janavi2008/JPSynth/README.md

# JPSynth
a finger drum machine with 8 drum pads, gesture controls, and its own amp and speaker. its also got a rotary encoder and an oled screen. the pads are piezo discs, and theres a distance sensor, so moving your hand up and down can bend the pitch or distort the sound

# Design
Ive used waveshare esp32 s3 zero module as the microcontroller, 8 piezoelectric discs, a vl53l0x sensor, an EC11 rotary encoder, an 1.3in oled screen, 2 pushbuttons, a MAX98357A amp module, and a 3W 8ohm speaker. i designed the enclosure, lid and caps for the drum pads in CAD.
each pad acts as its own drum - a kick drum, hi-hat, snare, crash, ride, mid tom, high tom and floor tom. one of the buttons will act as a hi-hat pedal. the rotary encoder can control the volume or change the kit. the distance sensor measures how high your left hand is and bends the pitch according to where you move it. the oled screen dispays the settings selected, and shows sound waves while playing.

the firmware is barebones, only the actual drum part and the gesture controls is done. the oled and a couple buttens are left, which ill do during the build as i didnt get enough time.

Schematic:


Pcb:


CAD:


# BOM

| Part | Quantity | Price | Vendor |
| :--- | :---: | :---: | :--- |
| Waveshare ESP32 S3 Zero | 1 | $6.31 | Robu.in |
| VL53L0X sensor | 1 | - | Robu.in |
| MAX98357 module | 1 | - | Robu.in |
| 1.3in OLED display | 1 | - | Robu.in |
| 3W 8Ohm speaker | 1 | - | Robu.in |
| 27mm piezo disc | 8 | $3 | Robu.in |
| smd BAT54S | 8 | $0.2 | Robu.in |
| 0805 smd 1M ohm resistor | 8 | $0.2 | Robu.in |
| 0805 smd 10k ohm resistor | 8 | $0.2 | Robu.in |
| EVA foam 5mm | - | $2 | Amazon.in |
| EC11 rotary encoder | 1 | $0.5 | Robu.in |
| SMD push buttons | 2 | $0.3 | Robu.in |
| 0805 smd 10uf capacitor | 1 | $0.1 | Robu.in |
| 0805 smd 0.1uf capacitor | 3 | $0.1 | Robu.in |
| PCB | 1 | $10 | zbotic.in |
| 3d prints | - | - | - |
