janavi2008/JPSynth/CAD/JPSynth_Assem.SLDASM

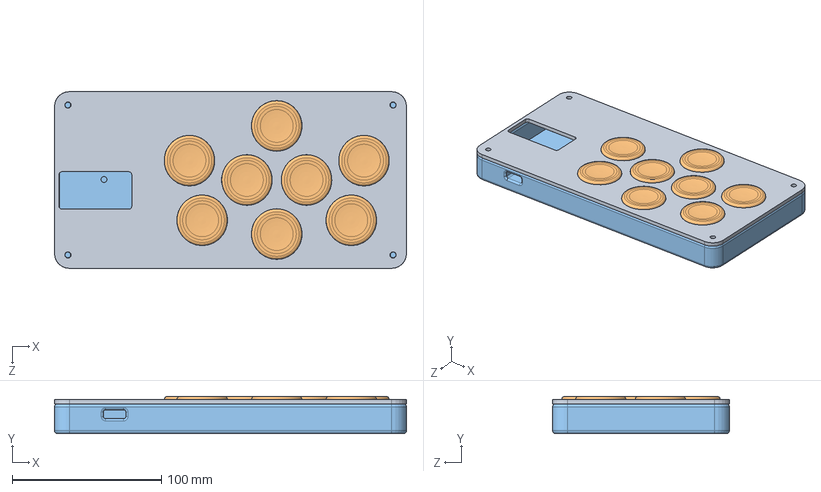
[picture p1: CAD file, 2026-10-25]
CAD/JPSynth_Assem.SLDASM
236.0 x 25.0 x 118.5 mm
CAD
JPSynth_Cap x 8
JPSynth_Lid
