janavi2008/JPSynth/CAD/CAD.SLDPRT

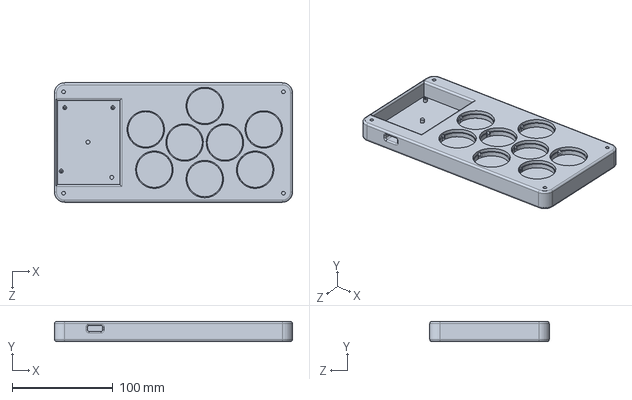
[picture p2: CAD file, 2026-10-25]
CAD/CAD.SLDPRT
236.0 x 20.0 x 118.5 mm
