janavi2008/JPSynth/CAD/JPSynth_Lid.SLDPRT

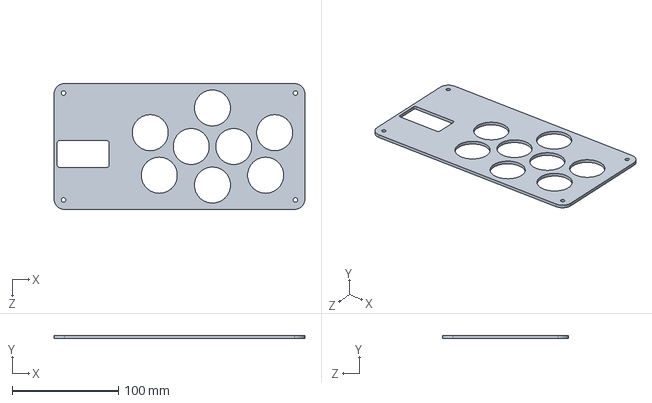
[picture p3: CAD file, 2026-10-25]
CAD/JPSynth_Lid.SLDPRT
236.0 x 3.00 x 118.5 mm
