janavi2008/JPSynth/CAD/JPSynth_Cap.SLDPRT

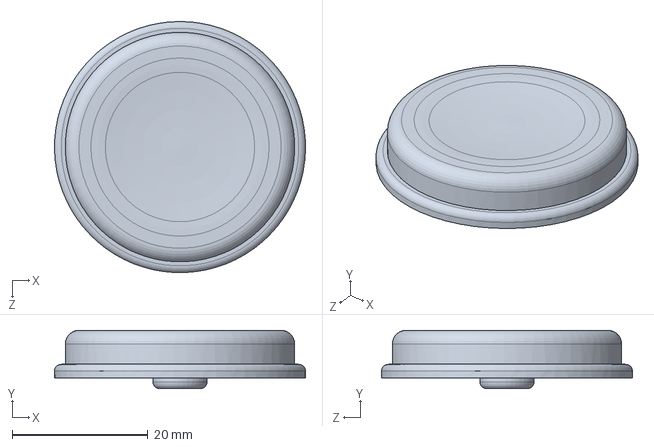
[picture p4: CAD file, 2026-10-25]
CAD/JPSynth_Cap.SLDPRT
37.0 x 8.60 x 37.0 mm
