janavi2008/JPSynth/PCBs/JPSynth.kicad_pcb

## KiCad design PCBs/JPSynth.kicad_pcb (2026-10-25)

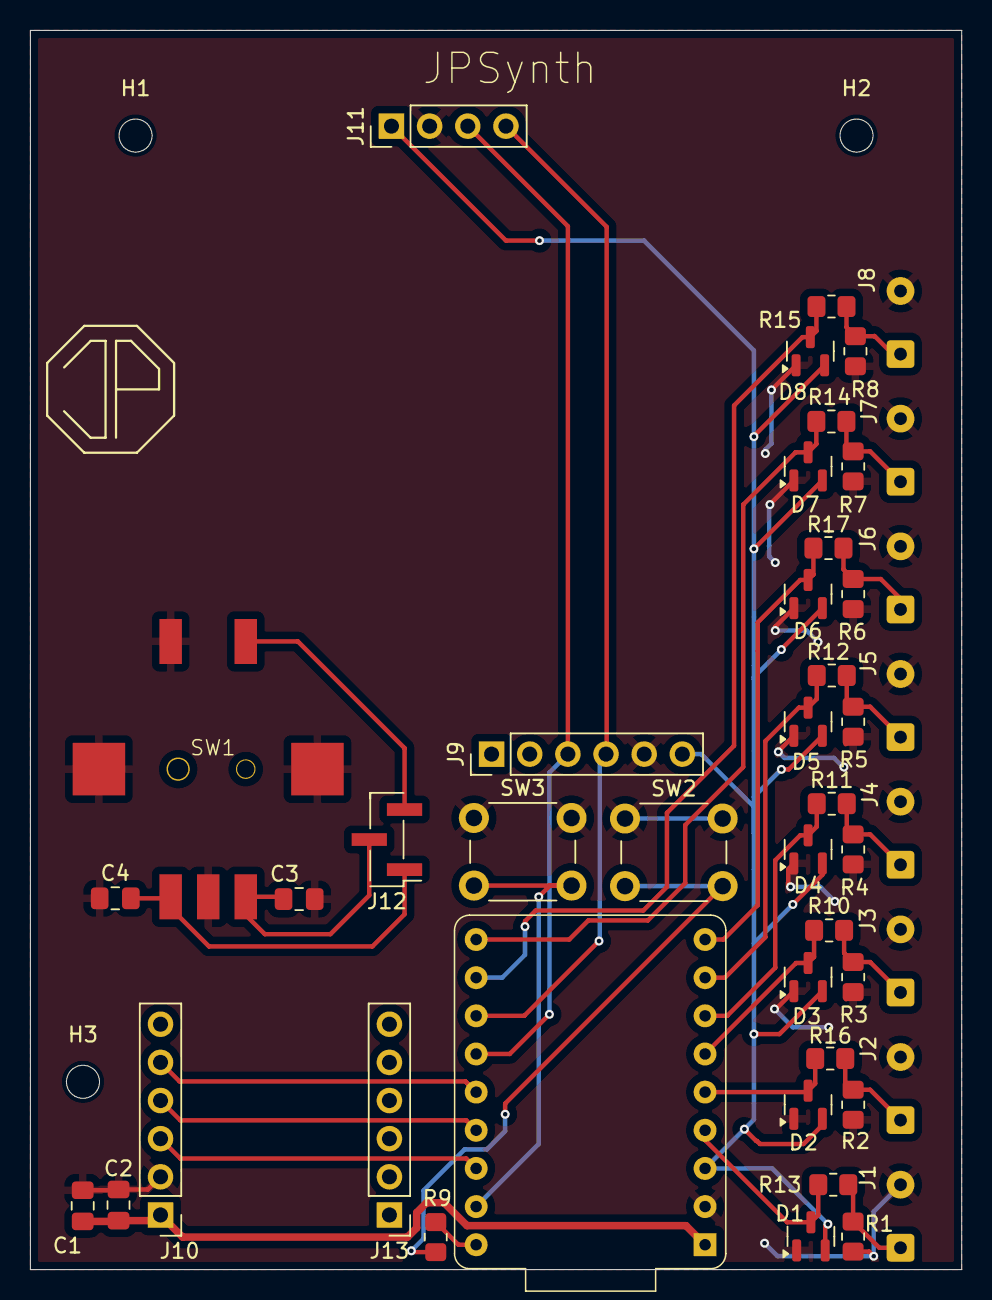
[picture p5: board JPSynth.kicad_pcb from above]

Board: 2 copper layers, 62.0 x 82.5 mm, 49 parts (0 on the bottom side), 30 nets.

Parts:
C1: 10uF; C_0805_2012Metric_Pad1.18x1.45mm_HandSolder
C2: 0.1uF; C_0805_2012Metric_Pad1.18x1.45mm_HandSolder
C3, C4: 0.1uf; C_0805_2012Metric_Pad1.18x1.45mm_HandSolder
D1, D2, D3, D4, D5, D6, D7, D8: BAT54S; SOT-23
H1, H2, H3: MountingHole; MountingHole_2.2mm_M2
J1: Piezo1; SolderWire-0.25sqmm_1x02_P4.2mm_D0.65mm_OD1.7mm
J2: Piezo2; SolderWire-0.25sqmm_1x02_P4.2mm_D0.65mm_OD1.7mm
J3: Piezo3; SolderWire-0.25sqmm_1x02_P4.2mm_D0.65mm_OD1.7mm
J4: Piezo4; SolderWire-0.25sqmm_1x02_P4.2mm_D0.65mm_OD1.7mm
J5: Piezo5; SolderWire-0.25sqmm_1x02_P4.2mm_D0.65mm_OD1.7mm
J6: Piezo6; SolderWire-0.25sqmm_1x02_P4.2mm_D0.65mm_OD1.7mm
J7: PIezo7; SolderWire-0.25sqmm_1x02_P4.2mm_D0.65mm_OD1.7mm
J8: Piezo8; SolderWire-0.25sqmm_1x02_P4.2mm_D0.65mm_OD1.7mm
J9: VL53L0X; PinHeader_1x06_P2.54mm_Vertical
J10: MAX98357A -1; PinHeader_1x06_P2.54mm_Vertical
J11: OLED; PinHeader_1x04_P2.54mm_Vertical
J12: ESP32-extra pads; PinHeader_1x03_P2.00mm_Vertical_SMD_Pin1Left
J13: MAX98357A -2; PinHeader_1x06_P2.54mm_Vertical
R1, R2, R3, R4, R5, R6, R7, R8: 1M; R_0805_2012Metric_Pad1.20x1.40mm_HandSolder
R9: 1k; R_0805_2012Metric_Pad1.20x1.40mm_HandSolder
R10, R11, R12, R13, R14, R15, R16, R17: 10k; R_0805_2012Metric_Pad1.20x1.40mm_HandSolder
SW1: RotaryEncoder_Switch_MP; rotary encoder
SW2, SW3: SW_Push; SW_PUSH_6mm
U1: ESP32-S3-Zero; Waveshare-ESP32-S3-Zero

Connections:
/+3V3: D1.2 (K), D2.2 (K), D3.2 (K), D4.2 (K), D5.2 (K), D6.2 (K), D7.2 (K), D8.2 (K), J9.6, J11.1, U1.3 (3V3(OUT))
/+5V: C1.1, C2.1, J10.1, U1.1 (VDD)
/GND: C1.2, C2.2, C3.2, C4.1, D1.1 (A), D2.1 (A), D3.1 (A), D4.1 (A), D5.1 (A), D6.1 (A), D7.1 (A), D8.1 (A), J1.2, J2.2, J3.2, J4.2, J5.2, J6.2, J7.2, J8.2, J9.5, J10.2, J11.2, R1.2, R2.2, R3.2, R4.2, R5.2, R6.2, R7.2, R8.2, SW1.1, SW1.3, SW1.5, SW2.1, SW3.1, U1.2 (GND)
/GPIO1_D1: D1.3 (COM), R13.2, U1.4 (GPIO1)
/GPIO2_D2: D2.3 (COM), R16.2, U1.5 (GPIO2)
/GPIO3_D3: D3.3 (COM), R10.2, U1.6 (GPIO3)
/GPIO4_D4: D4.3 (COM), R11.2, U1.7 (GPIO4)
/GPIO5_D5: D5.3 (COM), R12.2, U1.8 (GPIO5)
/GPIO6_D6: D6.3 (COM), R17.2, U1.9 (GPIO6)
/GPIO7_D7: D7.3 (COM), R14.2, U1.10 (GPIO7)
/GPIO8_D8: D8.3 (COM), R15.2, U1.11 (GPIO8)
/GPIO9_SDA: J9.4, J11.4, U1.12 (GPIO9)
/GPIO10_SCL: J9.3, J11.3, U1.13 (GPIO10)
/GPIO11_DIN: J10.5, U1.14 (GPIO11)
/GPIO12_BCLK: J10.4, U1.15 (GPIO12)
/GPIO13_LRC: J10.3, U1.16 (GPIO13)
/GPIO14: J12.3, SW1.6
/GPIO15: C3.1, J12.2, SW1.4
/GPIO16: C4.2, J12.1, SW1.2
/SW2_TX: R9.2, U1.18 (TX)
/SW3_RX: SW3.2, U1.17 (RX)
unnamed: J1.1, R1.1, R13.1
unnamed: J2.1, R2.1, R16.1
unnamed: J3.1, R3.1, R10.1
unnamed: J4.1, R4.1, R11.1
unnamed: J5.1, R5.1, R12.1
unnamed: J6.1, R6.1, R17.1
unnamed: J7.1, R7.1, R14.1
unnamed: J8.1, R8.1, R15.1
unnamed: R9.1, SW2.2
