janavi2008/JPSynth/JOURNAL.md

# JPSynth – devlog

<!-- Generated by Half Life from project cmvespvqc0a1q01rc3e3982db. Edits here are overwritten on the next sync. -->
<!-- Generated: 2026-10-24T20:44:40.041Z -->

> [!NOTE]
> This devlog is mirrored from [Half Life](https://halflife.hackclub.com) – [open the project](https://halflife.hackclub.com/projects/cmvespvqc0a1q01rc3e3982db). Editing it here will not change the platform's copy, and the next sync overwrites this file.

> a finger drum pad with gesture controls - it has 8 drum pads, and a distance sensor for gesture controls( moving your hand up or down to sweep a filter or bend the pitch)

| Week | Tier | Hours logged | Entries |
| --- | --- | --- | --- |
| Week 3 | Tier 2 | 12.28h | 5 |

## Contents

1. [2026-10-20 – Started off with the schematic, and just over an hour in it already so messy. i should have spaced it out more, but its alright. today i just finished off the drum pads, the sensors, amp, buttons, spe](#2026-10-20-started-off-with-the-schematic-and-just-over-an-h)
2. [2026-10-21 – finished the schematic, and i made some changes - added an oled and a rotary encoder. i had alot of trouble witht he footprints this time since im mostly using modules, it was a while before i figured](#2026-10-21-finished-the-schematic-and-i-made-some-changes---)
3. [2026-10-22 – Finished the entire pcb today, started by assigning lables in the schematic to make it easier to understand. it was smooth sailing after that, and i got the pcb designed and routed pretty easily. i co](#2026-10-22-finished-the-entire-pcb-today-started-by-assignin)
4. [2026-10-23 – i made some changes to the pcb, added 2 push buttons because i realised i can also use rx and tx as i/o pins(with some limitations). i also added mounting holes to the pcb, and added design clearances](#2026-10-23-i-made-some-changes-to-the-pcb-added-2-push-butto)
5. [2026-10-24 – I finished up the cad, added a lid that I'm gonna get cut into acrylic so it's see through, and designed the caps for the drum pads. Ive decided the materials for the inner part of the pads(eva). One](#2026-10-24-i-finished-up-the-cad-added-a-lid-that-im-gonna-g)

## Design

### 2026-10-20 – Started off with the schematic, and just over an hour in it already so messy. i should have spaced it out more, but its alright. today i just finished off the drum pads, the sensors, amp, buttons, spe

**1.32h**

Started off with the schematic, and just over an hour in it already so messy. i should have spaced it out more, but its alright. today i just finished off the drum pads, the sensors, amp, buttons, speakers ill do next session.
heres the schematic till now



[Timelapse](https://lookout.hackclub.com/api/media/a15c3f82-49b0-4342-b299-bd029b77fd37/video.mp4)

### 2026-10-21 – finished the schematic, and i made some changes - added an oled and a rotary encoder. i had alot of trouble witht he footprints this time since im mostly using modules, it was a while before i figured

**2.58h**

finished the schematic, and i made some changes - added an oled and a rotary encoder. i had alot of trouble witht he footprints this time since im mostly using modules, it was a while before i figured i just had to add header pins. i did have to create a custom footprint for the rotary encoder, but thankfully there was adatasheet with all the dimensions.
heres the final(ish) schematic



[Timelapse](https://lookout.hackclub.com/api/media/00f93358-e980-4481-893a-c57018e11910/video.mp4)

### 2026-10-22 – Finished the entire pcb today, started by assigning lables in the schematic to make it easier to understand. it was smooth sailing after that, and i got the pcb designed and routed pretty easily. i co

**3.58h**

Finished the entire pcb today, started by assigning lables in the schematic to make it easier to understand. it was smooth sailing after that, and i got the pcb designed and routed pretty easily. i considered removing one drum pad in favour of a button or slider(ive currently maxed out my i/o pins), but decided against it for now cuz i dont even know what id use the button for, as my rotary encoder plus gesture sensor already covers everything. i thought id start off with the cad, but solidworks had different ideas- it hung literally 1 minute after i opened it, so i decided to call it a day

heres the updated schematic and pcb:





[Timelapse](https://lookout.hackclub.com/api/media/58ecd70d-abc6-41af-927c-59f197b77dbb/video.mp4)

### 2026-10-23 – i made some changes to the pcb, added 2 push buttons because i realised i can also use rx and tx as i/o pins(with some limitations). i also added mounting holes to the pcb, and added design clearances

**2.98h**

i made some changes to the pcb, added 2 push buttons because i realised i can also use rx and tx as i/o pins(with some limitations). i also added mounting holes to the pcb, and added design clearances cuz i had forgotten to earlier. i designed the base of the enclosure, and i and im happy with how it turned out, though right now my usb cord will have to go through a 15mm tunnel to reach the esp32 port, so i might have to change that.i did some research to figure out what material and how thick the pads have to be(piezo sensor sandwiched between foam/rubber), though im still not entirely sure on how to design them for max sensitivity.

heres the enclosure:


[Timelapse](https://lookout.hackclub.com/api/media/802de4b8-7ace-4907-97e4-b3e4006c3694/video.mp4)

[Timelapse](https://lookout.hackclub.com/api/media/d4d22928-646a-42d3-9ae7-a29f25475254/video.mp4)

### 2026-10-24 – I finished up the cad, added a lid that I'm gonna get cut into acrylic so it's see through, and designed the caps for the drum pads. Ive decided the materials for the inner part of the pads(eva). One

**1.82h**

I finished up the cad, added a lid that I'm gonna get cut into acrylic so it's see through, and designed the caps for the drum pads. Ive decided the materials for the inner part of the pads(eva). One problem is that I can't find an appropriate speaker, but i can figure that out by build week. I also added a resistor in series with each piezo pad for more protection, buz i had to move alot of things around in the pcb

[Timelapse](https://lookout.hackclub.com/api/media/d0ad9425-892a-4002-92b7-3dfc2a0b755e/video.mp4)
