janavi2008/JPSynth/(commit log)

2026-10-23 Sync JPSynth from Half Life
    [BOM.csv]
2026-10-25 Rename Untitled spreadsheet - Sheet1 (3).csv to BOM.csv
    [BOM.csv]
